batmanatucsd/uMouse/3D Design/MotorMount.stl

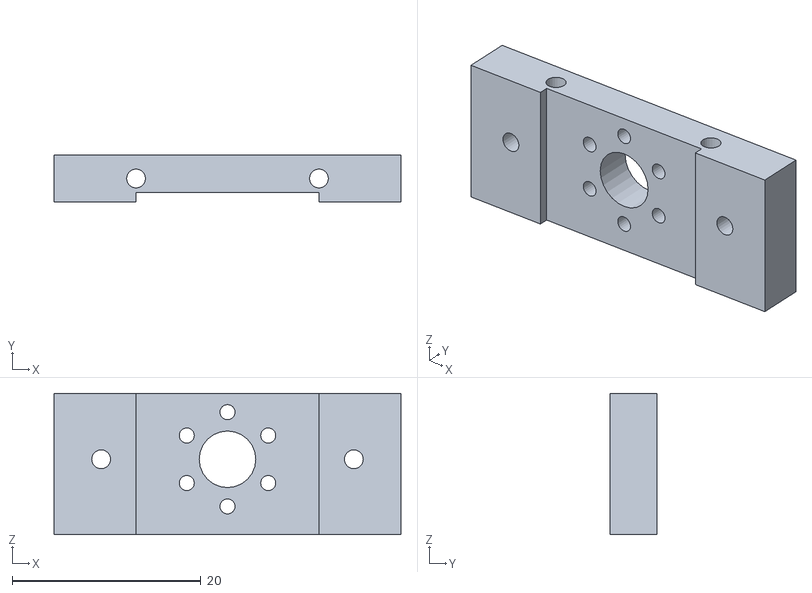
[picture p1: CAD file, 2015-02-12]
3D Design/MotorMount.stl
36.8 x 5.00 x 15.0
