batmanatucsd/uMouse/3D Design/Wheel.stl

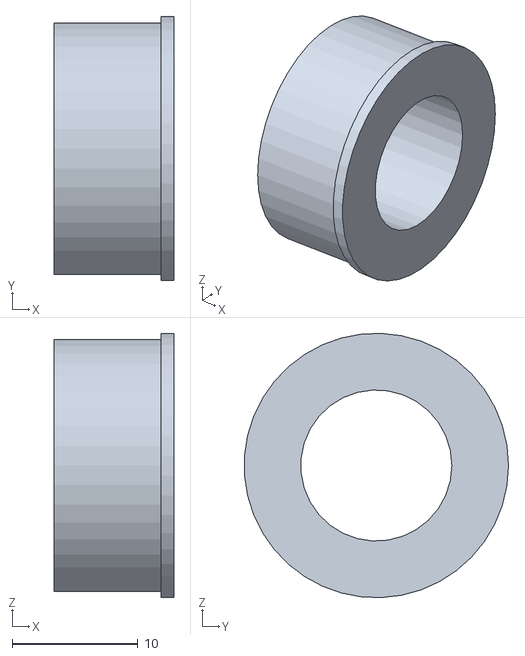
[picture p2: CAD file, 2015-02-12]
3D Design/Wheel.stl
9.50 x 21.0 x 21.0
