batmanatucsd/uMouse/(list of files, cad)

Other CAD files:
3D Design/MotorMount.dwg
3D Design/Wheel.dwg
