batmanatucsd/uMouse/Code/Algm/testmaze1.gif

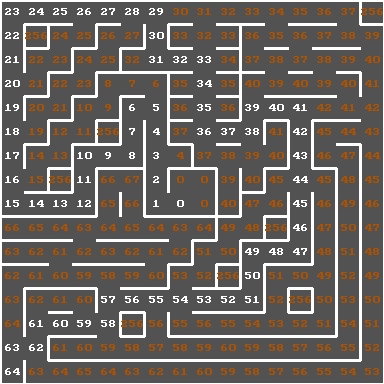
Code/Algm/testmaze1.gif
