batmanatucsd/uMouse/PCB Design/mouse_design/mouse_design.brd

## EAGLE design PCB Design/mouse_design/mouse_design.brd (2015-03-25)

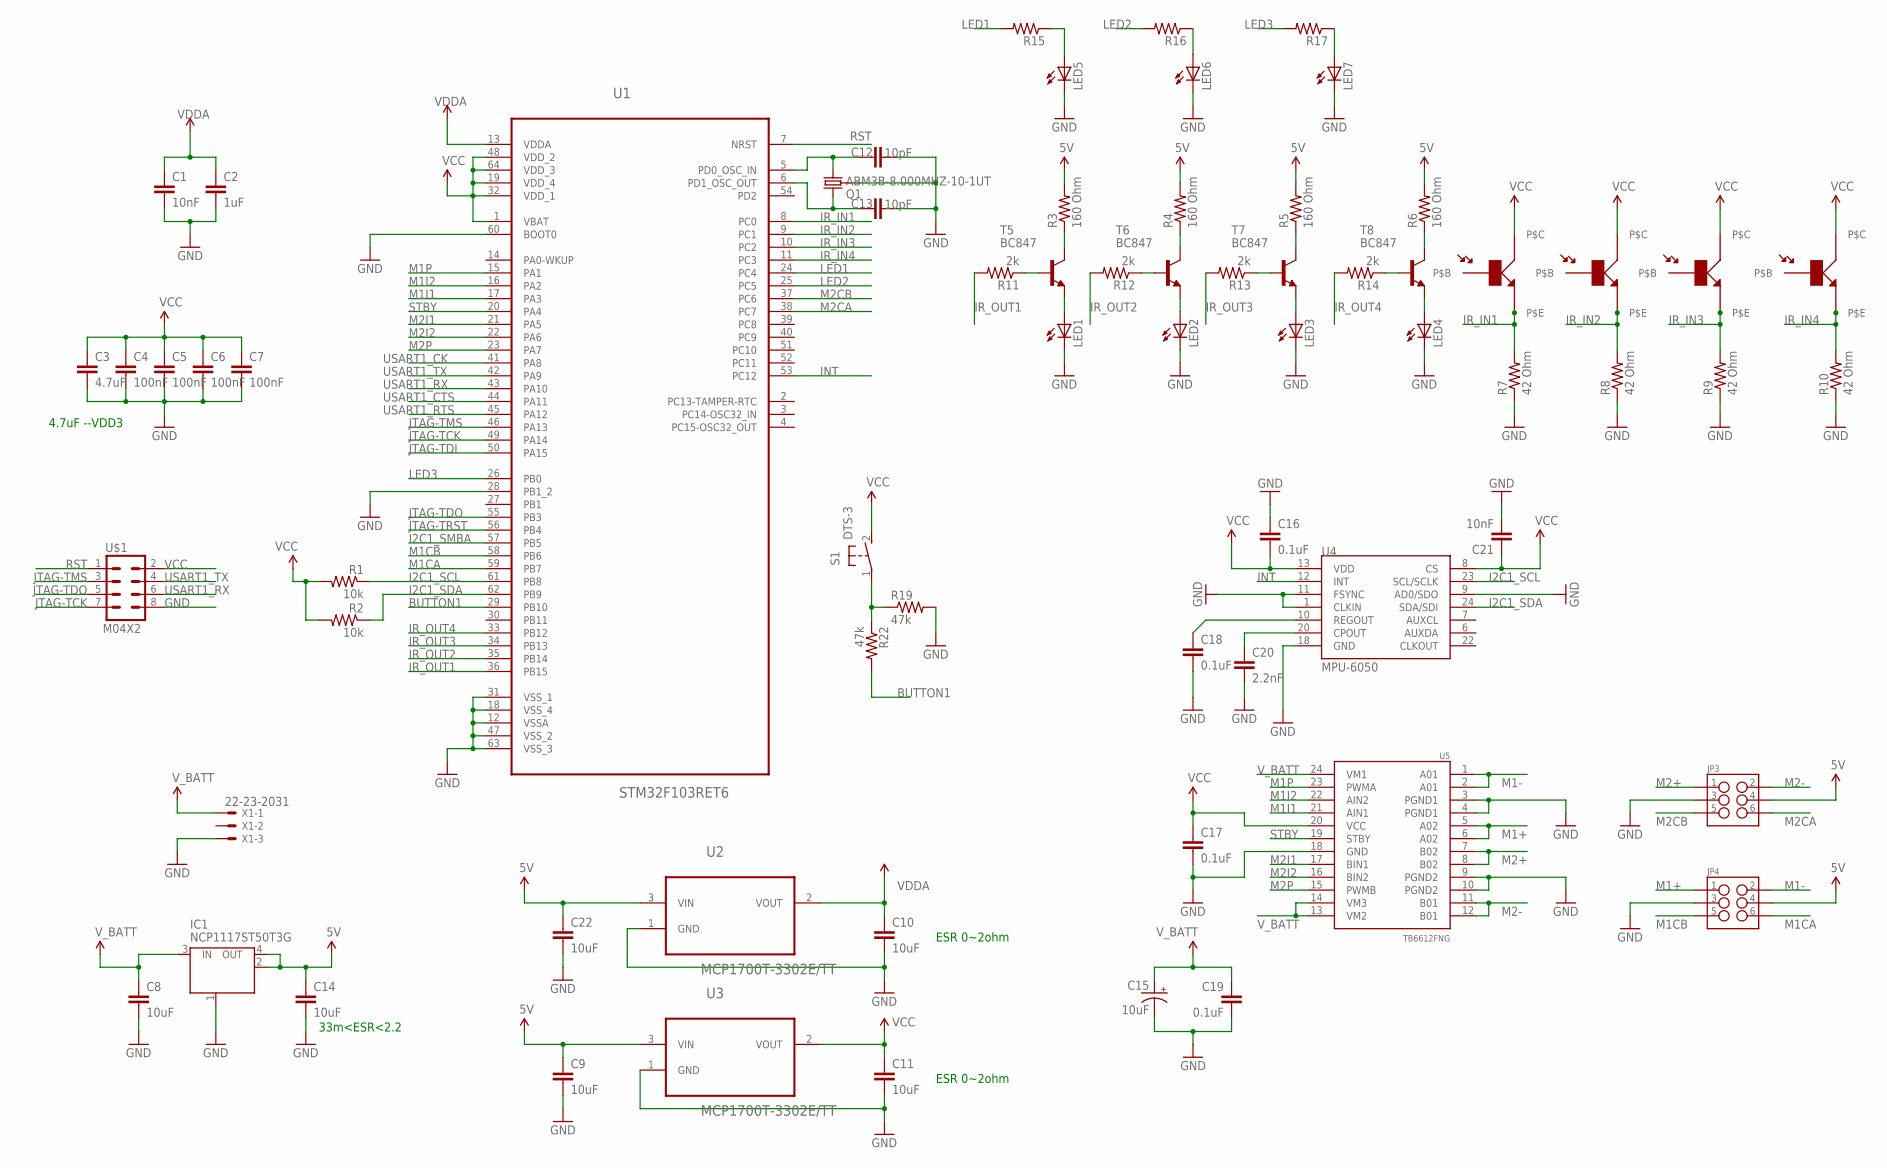
[picture p4: schematic mouse_design.sch]

Parts:
C1, C21: 10nF; 0805
C2: 1uF; 0805
C3: 4.7uF; 0805
C4, C5, C6, C7: 100nF; 0805
C8, C9, C10, C11, C14, C22: 10uF; 0805
C12, C13: 10pF; 0805
C15: 10uF; EIA3216-KIT
C16, C17, C18, C19: 0.1uF; 0805
C20: 2.2nF; 0805
IC1: NCP1117ST50T3G; SOT223
JP3, JP4: M03X2NO_SILK; 2X3-NS
LED1, LED2, LED3, LED4: LED5MM
LED5, LED6, LED7: LEDSML0805; SML0805
Q1: ABM3B-8.000MHZ-10-1UT; CRYSTAL-SMD-5X3
R1, R2: 10k; 0805
R3, R4, R5, R6: 160 Ohm; 0805
R7, R8, R9, R10: 42 Ohm; 0805
R11, R12, R13, R14: 2k; 0805
R15, R16, R17: RESISTOR0805-RES; 0805
R19, R22: 47k; 0805
S1: DTS-3
T5, T6, T7, T8: BC847; SOT23
U1: STM32F103RET6; QFP50P1200X1200X160-64N
U2, U3: MCP1700T-3302E/TT; SOT95P237X112-3N
U4: MPU-6050; QFN-24-TESTING
U5: TB6612FNG; SSOP24
U$1: M04X2; 2X4
U$2, U$3, U$4, U$5: PHTRST
X1: 22-23-2031

Connections:
5V: C9.1, C14.1, C22.1, IC1.2 (OUT), IC1.4 (OUT), JP3.4, JP4.4, R3.2, R4.2, R5.2, R6.2, U2.3 (VIN), U3.3 (VIN)
BUTTON1: R22.2, U1.29 (PB10)
GND: C1.2, C2.2, C3.2, C4.2, C5.2, C6.2, C7.2, C8.2, C9.2, C10.2, C11.2, C12.1, C13.1, C14.2, C15.C (-), C16.1, C17.2, C18.2, C19.2, C20.2, C21.2, C22.2, IC1.1 (GND/ADJ), JP3.3, JP4.3, LED1.K (C), LED2.K (C), LED3.K (C), LED4.K (C), LED5.C, LED6.C, LED7.C, Q1.2 (3), Q1.4 (3), R7.1, R8.1, R9.1, R10.1, R19.2, U1.12 (VSSA), U1.18 (VSS_4), U1.28 (PB1_2), U1.31 (VSS_1), U1.47 (VSS_2), U1.60 (BOOT0), U1.63 (VSS_3), U2.1 (GND), U3.1 (GND), U4.1 (CLKIN), U4.9 (AD0/SDO), U4.11 (FSYNC), U4.18 (GND), U5.3 (PGND1), U5.4 (PGND1), U5.9 (PGND2), U5.10 (PGND2), U5.18 (GND), U$1.8, X1.3
I2C1_SCL: R1.1, U1.61 (PB8), U4.23 (SCL/SCLK)
I2C1_SDA: R2.1, U1.62 (PB9), U4.24 (SDA/SDI)
I2C1_SMBA: U1.57 (PB5)
INT: U1.53 (PC12), U4.12 (INT)
IR_IN1: R7.2, U1.8 (PC0), U$2.P$E
IR_IN2: R8.2, U1.9 (PC1), U$3.P$E
IR_IN3: R9.2, U1.10 (PC2), U$4.P$E
IR_IN4: R10.2, U1.11 (PC3), U$5.P$E
IR_OUT1: R11.2, U1.36 (PB15)
IR_OUT2: R12.2, U1.35 (PB14)
IR_OUT3: R13.2, U1.34 (PB13)
IR_OUT4: R14.2, U1.33 (PB12)
JTAG-TCK: U1.49 (PA14), U$1.7
JTAG-TDI: U1.50 (PA15)
JTAG-TDO: U1.55 (PB3), U$1.5
JTAG-TMS: U1.46 (PA13), U$1.3
JTAG-TRST: U1.56 (PB4)
LED1: R15.2, U1.24 (PC4)
LED2: R16.2, U1.25 (PC5)
LED3: R17.2, U1.26 (PB0)
M1+: JP4.1, U5.5 (A02), U5.6 (A02)
M1-: JP4.2, U5.1 (A01), U5.2 (A01)
M1CA: JP4.6, U1.59 (PB7)
M1CB: JP4.5, U1.58 (PB6)
M1I1: U1.17 (PA3), U5.21 (AIN1)
M1I2: U1.16 (PA2), U5.22 (AIN2)
M1P: U1.15 (PA1), U5.23 (PWMA)
M2+: JP3.1, U5.7 (B02), U5.8 (B02)
M2-: JP3.2, U5.11 (B01), U5.12 (B01)
M2CA: JP3.6, U1.38 (PC7)
M2CB: JP3.5, U1.37 (PC6)
M2I1: U1.21 (PA5), U5.17 (BIN1)
M2I2: U1.22 (PA6), U5.16 (BIN2)
M2P: U1.23 (PA7), U5.15 (PWMB)
unnamed: C12.2, Q1.3 (1), U1.5 (PD0_OSC_IN)
unnamed: R4.1, T6.3 (C)
unnamed: LED1.A, T5.2 (E)
unnamed: LED2.A, T6.2 (E)
unnamed: C13.2, Q1.1 (2), U1.6 (PD1_OSC_OUT)
unnamed: LED3.A, T7.2 (E)
unnamed: C20.1, U4.20 (CPOUT)
unnamed: C18.1, U4.10 (REGOUT)
unnamed: LED4.A, T8.2 (E)
unnamed: R3.1, T5.3 (C)
unnamed: R5.1, T7.3 (C)
unnamed: R6.1, T8.3 (C)
unnamed: R14.1, T8.1 (B)
unnamed: R13.1, T7.1 (B)
unnamed: R12.1, T6.1 (B)
unnamed: R11.1, T5.1 (B)
unnamed: LED5.A, R15.1
unnamed: LED6.A, R16.1
unnamed: LED7.A, R17.1
unnamed: R19.1, R22.1, S1.1
RST: U1.7 (NRST), U$1.1
STBY: U1.20 (PA4), U5.19 (STBY)
USART1_CK: U1.41 (PA8)
USART1_CTS: U1.44 (PA11)
USART1_RTS: U1.45 (PA12)
USART1_RX: U1.43 (PA10), U$1.6
USART1_TX: U1.42 (PA9), U$1.4
VCC: C3.1, C4.1, C5.1, C6.1, C7.1, C11.1, C16.2, C17.1, C21.1, R1.2, R2.2, S1.2, U1.1 (VBAT), U1.19 (VDD_4), U1.32 (VDD_1), U1.48 (VDD_2), U1.64 (VDD_3), U3.2 (VOUT), U4.8 (CS), U4.13 (VDD), U5.20 (VCC), U$1.2, U$2.P$C, U$3.P$C, U$4.P$C, U$5.P$C
VDD: C1.1, C2.1, C10.1, U1.13 (VDDA), U2.2 (VOUT)
V_BATT: C8.1, C15.A (+), C19.1, IC1.3 (IN), U5.13 (VM2), U5.14 (VM3), U5.24 (VM1), X1.1

Notes on the sheet:
ESR 0~2ohm
4.7uF --VDD3
33m<ESR<2.2

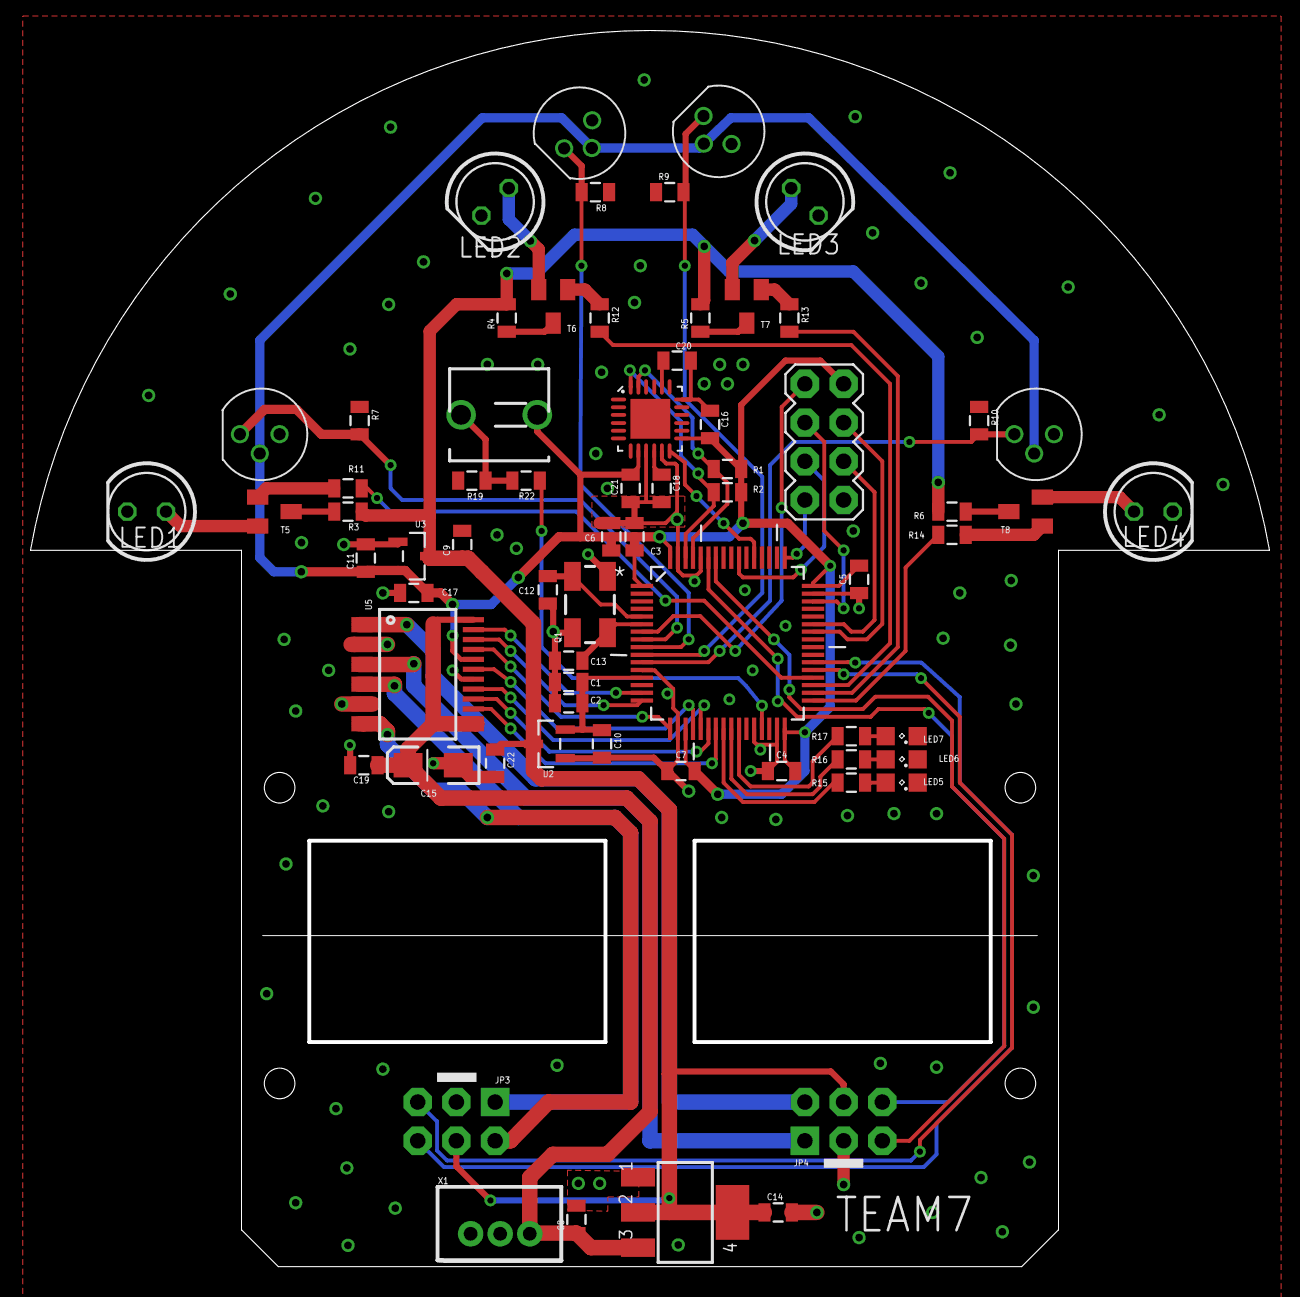
[picture p5: board mouse_design.brd from above]

Board: 2 copper layers, 81.3 x 81.1 mm, 68 parts (0 on the bottom side), 61 nets.
