batmanatucsd/uMouse/Code/src/uMouse.c

#include "mouse.h"
#include "anbt_dmp_driver.h"
#include "anbt_dmp_fun.h"
#include "anbt_dmp_mpu6050.h"

/*****************************************************************************/
// Global Variables
/*****************************************************************************/
__IO uint16_t sensor_buffers[4];
__IO uint16_t sensor_readings[4];
extern float angle[3];
extern int16_t raw_data[6];
extern int16_t offset[6];

/*****************************************************************************/
// Main Function
/*****************************************************************************/
int main(void)
{
  // MCU Configurations
  RCC_Configuration();
  GPIO_Configuration();
  DMA_Configuration();
  NVIC_Configuration();

  ADC_Configuration();
  PWM_Configuration();
  ENCODER_Configuration();



  // Only for debug
  USART_Configuration();
  ANBT_I2C_Configuration();
  AnBT_DMP_MPU6050_Init();

  mouse_state = STOP;
  mouse_status = FORWARD;

  while(1)
  {
	  listen_for_button();

	  printf("test");

	  // Listen to button push
	  listen_for_button();

	  switch(mouse_state){
		  case GO:
			  /*****************************************CELL BY CELL MOVEMENT****************************/


			     ADC_Read(1,0,0,1);

			     if(sensor_buffers[L_IR] > 120 && sensor_buffers[R_IR] > 120){
			     stopFrontWall();

			     if(sensor_buffers[L_IR]>400){

			     change_LeftMotorSpeed(0);
			     change_RightMotorSpeed(0);

			     Delay_us(1000);
			     rightTurn();
			     Delay_us(10000);

			     }
			     }
			     else{
				  L_ENC->CNT=0;
				  R_ENC->CNT=0;

				  while(L_ENC->CNT < 6005 && R_ENC->CNT < 6005){
					  change_LeftMotorSpeed(80);
					  change_RightMotorSpeed(80);
					  pid();

					  if(L_ENC->CNT >3000 && L_ENC->CNT<4000){
						  change_LeftMotorSpeed(60);
						  change_RightMotorSpeed(60);
						  pid();
					  }

					  if(L_ENC->CNT>=4000 && L_ENC->CNT<5000){
						  change_LeftMotorSpeed(40);
						  change_RightMotorSpeed(40);
						  pid();
					  }

				  }
				  change_LeftMotorSpeed(0);
				  change_RightMotorSpeed(0);


				  Delay_us(1000000);
				  L_ENC->CNT=0;
				  R_ENC->CNT=0;

			}










			  /******************************LEFT 90 TURN******************************************/
			  /*	ADC_Read(1,0,0,1);

				if(sensor_buffers[L_IR] > 120 && sensor_buffers[R_IR] > 120){
				stopFrontWall();

				if(sensor_buffers[L_IR]>400){

				change_LeftMotorSpeed(0);
				change_RightMotorSpeed(0);

				Delay_us(1000);
				leftTurn();
				Delay_us(10000);

				}
				}
				else{
				change_LeftMotorSpeed(150);
				change_RightMotorSpeed(150);
				pid();

				}
			   */


			  /*******************************TEST SMOOTH RIGHT***********************************/
			  /*	ADC_Read(1,1,1,1);

				change_LeftMotorSpeed(150);
				change_RightMotorSpeed(150);
				pid();
				rightTurn();
			   */

			  break;


		  case TEST:


			  /******************************straight, stop, right, etc *****************/
/*
			     ADC_Read(1,0,0,1);

			     if(sensor_buffers[L_IR] > 120 && sensor_buffers[R_IR] > 120){
			     stopFrontWall();

			     if(sensor_buffers[L_IR]>400){

			     change_LeftMotorSpeed(0);
			     change_RightMotorSpeed(0);

			     Delay_us(1000);
			     rightTurn();
			     Delay_us(10000);

			     }
			     }
			     else{
			     change_LeftMotorSpeed(150);
			     change_RightMotorSpeed(150);
			     pid();
			     }

*/
			  /*******************************straight, stop, 180, go ********************/

			     ADC_Read(1,0,0,1);
			     if(sensor_buffers[L_IR] > 120 && sensor_buffers[R_IR] > 120){
			     stopFrontWall();

			     if(sensor_buffers[L_IR]>490){

			     Delay_us(1000);
			     rightTurn();
			     Delay_us(10000);
			     }
			     }
			     else{
			     change_LeftMotorSpeed(150);
			     change_RightMotorSpeed(150);
			     pid();
			     }




			  GPIO_SetBits(GPIOC, GREEN);
			  GPIO_ResetBits(GPIOB, RED);
			  GPIO_ResetBits(GPIOC, YELLOW);
			  break;

		  case STOP:

			  //ADC_Read(1, 1, 1, 1);
			  turnMotorOff();
			  GPIO_SetBits(GPIOB, RED);
			  GPIO_ResetBits(GPIOC, GREEN);
			  GPIO_SetBits(GPIOC, YELLOW);

			  /*printf("  sensor reading: %u         %u        %u        %u\r\n",*/
			  /*sensor_buffers[3], sensor_buffers[2], sensor_buffers[1], sensor_buffers[0]);*/

			  /*Free our mouse*/
			  if(sensor_buffers[R_IR] >= 450) {
				  Delay_us(10000);
				  mouse_state = GO;
			  }
			  /*if(sensor_buffers[L_IR] >= 450) {*/
			  /*Delay_us(10000);*/
			  /*calibrate();*/
			  /*GPIO_SetBits(GPIOC, GREEN);*/
			  /*Delay_us(10000);*/
			  /*}*/

			  break;

	  /*printf("%u            %u\r\n", TIM3->CCR3, TIM4->CCR4);*/
	  /*printf("                                                  %u              %u\r\n", L_ENC->CNT, R_ENC->CNT);*/
	  /*    ADC_Read(1,1,1,1);
		printf("                                                    %u      %u      %u\r\n"
		sensor_readings[0], sensor_readings[1], sensor_readings[2], sensor_readings[3]);*/
	  /*ADC1->JDR1, ADC1->JDR2, ADC1->JDR3, ADC1->JDR4);*/
	  /*ADC1->JOFR1, ADC1->JOFR2, ADC1->JOFR3, ADC1->JOFR4);*/
	  /*printf("%u            %u\r\n", TIM8->CNT, TIM4->CNT);*/
	  /*if(TIM8->CNT > 7000)*/
	  /*turnMotorOff();*/

  }
}
}
