batmanatucsd/uMouse/Code/src/pid.h

#ifndef PID_H
#define PID_H

// Constants
// IR_OUT:
// 1 - left
// 2 - front left
// 3 - front right
// 4 - right

#include "mouse.h"
#define RIGHT_THRESHOLD 200
#define LEFT_THRESHOLD 130


#define KP 0.01000
#define KD 0.2
#define KI 0
#define ADJUST 600

#ifndef HIGH
#define HIGH 1
#endif

#ifndef LOW
#define LOW 0
#endif

typedef enum {
  BOTH, RIGHT, LEFT, NOWALLS
} PID_CASE;

/*****************************************************************************/
// Calibrated values
/*****************************************************************************/
static uint16_t RIGHTWALL_TARGET = 300;
static uint16_t LEFTWALL_TARGET = 300;
static uint16_t OFFSET = 0; 

/*****************************************************************************/
// Functions
/*****************************************************************************/
void pid(void);
void calibrate(void);

#endif // PID_H
