batmanatucsd/uMouse/Code/src/mcu_lib.c

#include "mcu_lib.h"

/*****************************************************************************/
// Global Variables
/*****************************************************************************/
__IO uint16_t readADC_status = 0;
static __IO int16_t wait_time = 0;
__IO uint16_t waiting = 0;
__IO uint16_t sensor_buffers[4];
__IO uint16_t sensor_readings[4];

/*****************************************************************************/
// RCC_Configuration
//
// @brief: Configure clocks for the peripherals
/*****************************************************************************/
void RCC_Configuration(void) /*{{{*/
{
	/* PCLK2 is the APB2 clock */
  /* ADCCLK = PCLK2/6 = 72/6 = 12MHz*/
  // RCC_ADCCLKConfig(RCC_PCLK2_Div6);

  //enable DMA1 clock
  RCC_AHBPeriphClockCmd(RCC_AHBPeriph_DMA1 | RCC_AHBPeriph_DMA2, ENABLE);

  /* ADCCLK = PCLK2/4 for ADC */
  RCC_ADCCLKConfig(RCC_PCLK2_Div4);

   /* TIM clock enable for PWM */
  RCC_APB1PeriphClockCmd(RCC_APB1Periph_TIM3 | RCC_APB1Periph_TIM5, ENABLE);

  /* TIM clock enable for Encoder */
  RCC_APB1PeriphClockCmd(RCC_APB1Periph_TIM4, ENABLE);
  RCC_APB2PeriphClockCmd(RCC_APB2Periph_TIM8, ENABLE);

  // TODO: TIM clock enable for encoder counts

  /* GPIO, ADC clock enable */
  RCC_APB2PeriphClockCmd(RCC_APB2Periph_GPIOA | RCC_APB2Periph_GPIOB |
                         RCC_APB2Periph_GPIOC | RCC_APB2Periph_AFIO |
                         RCC_APB2Periph_ADC3 | RCC_APB2Periph_ADC3, ENABLE);

}/*}}}*/

/*****************************************************************************/
// GPIO_Configuration
//
// @brief: Set general purpose input & output pin configurations
/*****************************************************************************/
void GPIO_Configuration(void) /*{{{*/
{
	GPIO_InitTypeDef GPIO_InitStructure;

	// ***** For LED's ***** //
  GPIO_InitStructure.GPIO_Pin = GPIO_Pin_5 | GPIO_Pin_4;
  GPIO_InitStructure.GPIO_Speed = GPIO_Speed_50MHz;
  GPIO_InitStructure.GPIO_Mode = GPIO_Mode_Out_PP;
  GPIO_Init(GPIOC, &GPIO_InitStructure);

  GPIO_InitStructure.GPIO_Pin = GPIO_Pin_0;
  GPIO_InitStructure.GPIO_Speed = GPIO_Speed_50MHz;
  GPIO_InitStructure.GPIO_Mode = GPIO_Mode_Out_PP;
  GPIO_Init(GPIOB, &GPIO_InitStructure);

	// ***** For Push Button ***** //
  GPIO_InitStructure.GPIO_Pin = GPIO_Pin_10;
  GPIO_InitStructure.GPIO_Speed = GPIO_Speed_50MHz;
  GPIO_InitStructure.GPIO_Mode = GPIO_Mode_IN_FLOATING;
  GPIO_Init(GPIOB, &GPIO_InitStructure);

	// ***** For IR Sensors ***** //
  GPIO_InitStructure.GPIO_Pin = GPIO_Pin_0 | GPIO_Pin_1 |
                                GPIO_Pin_2 | GPIO_Pin_3;
  GPIO_InitStructure.GPIO_Mode = GPIO_Mode_AIN;
  GPIO_Init(GPIOC, &GPIO_InitStructure);

  GPIO_InitStructure.GPIO_Pin = GPIO_Pin_12 | GPIO_Pin_13 |
                                GPIO_Pin_14 | GPIO_Pin_15;
  GPIO_InitStructure.GPIO_Speed = GPIO_Speed_50MHz;
  GPIO_InitStructure.GPIO_Mode = GPIO_Mode_Out_PP;
  GPIO_Init(GPIOB, &GPIO_InitStructure);

	// ***** For Motor Controls ***** //
  GPIO_InitStructure.GPIO_Pin = GPIO_Pin_4 | GPIO_Pin_2 | GPIO_Pin_3 |
                                GPIO_Pin_5 | GPIO_Pin_6;
  GPIO_InitStructure.GPIO_Speed = GPIO_Speed_50MHz;
  GPIO_InitStructure.GPIO_Mode = GPIO_Mode_Out_PP;
  GPIO_Init(GPIOA, &GPIO_InitStructure);

	// ***** For PWM output ***** //
  GPIO_InitStructure.GPIO_Pin = GPIO_Pin_1 | GPIO_Pin_7;
  GPIO_InitStructure.GPIO_Mode = GPIO_Mode_AF_PP;
  GPIO_InitStructure.GPIO_Speed = GPIO_Speed_50MHz;
  GPIO_Init(GPIOA, &GPIO_InitStructure);

	// ***** For Encoder Inputs ***** //
  GPIO_InitStructure.GPIO_Pin = GPIO_Pin_6 | GPIO_Pin_7;
  GPIO_InitStructure.GPIO_Mode = GPIO_Mode_IPU;
  GPIO_InitStructure.GPIO_Speed = GPIO_Speed_50MHz;
  GPIO_Init(GPIOB, &GPIO_InitStructure);
  GPIO_Init(GPIOC, &GPIO_InitStructure);
}/*}}}*/

/*****************************************************************************
// DMA_Configuration
//
// @brief: Set configurations for DMA
/*****************************************************************************/
void DMA_Configuration(void) /*{{{*/
{
  //create DMA structure
  DMA_InitTypeDef  DMA_InitStructure;

  //reset DMA1 channe1 to default values;/*{{{*/
  DMA_DeInit(DMA2_Channel5);

  //channel will be used for memory to memory transfer
  DMA_InitStructure.DMA_M2M = DMA_M2M_Disable;
  //setting normal mode (non circular)
  DMA_InitStructure.DMA_Mode = DMA_Mode_Circular;
  //medium priority
  DMA_InitStructure.DMA_Priority = DMA_Priority_High;

  //chunk of data to be transfered
  DMA_InitStructure.DMA_BufferSize = 4; // use 4 when using 4 IR sensors
  //source and destination data size word=32bit
  DMA_InitStructure.DMA_PeripheralDataSize = DMA_PeripheralDataSize_HalfWord;
  DMA_InitStructure.DMA_MemoryDataSize = DMA_MemoryDataSize_HalfWord;

  //Location assigned to peripheral register will be source
  DMA_InitStructure.DMA_DIR = DMA_DIR_PeripheralSRC;

  //source and destination start addresses
  DMA_InitStructure.DMA_PeripheralBaseAddr = (uint32_t)&ADC3->DR;
  DMA_InitStructure.DMA_MemoryBaseAddr = (uint32_t)sensor_buffers;
  /*DMA_InitStructure.DMA_MemoryBaseAddr = (uint32_t)&ADC3->JOFR1;*/
  /*DMA_InitStructure.DMA_MemoryBaseAddr = (uint32_t)&ADC3->JOFR1;*/

  //source address increment disable
  DMA_InitStructure.DMA_PeripheralInc = DMA_PeripheralInc_Disable;
  //automatic memory destination increment enable.
  DMA_InitStructure.DMA_MemoryInc = DMA_MemoryInc_Enable;

  //send values to DMA registers
  DMA_Init(DMA2_Channel5, &DMA_InitStructure);
  /*Enable DMA1 Channel Transfer Complete interrupt*/
  DMA_ITConfig(DMA2_Channel5, DMA_IT_TC, ENABLE);
  DMA_Cmd(DMA2_Channel5, ENABLE); //Enable the DMA1 - Channel1/*}}}*/

  /*// DMA2 Channe5 Configuration;[>{{{<]*/
  /*DMA_DeInit(DMA2_Channel5);*/
  /*DMA_InitStructure.DMA_DIR = DMA_DIR_PeripheralSRC;*/
  /*[>DMA_InitStructure.DMA_PeripheralBaseAddr = (uint32_t)&ADC3->DR;<]*/
  /*DMA_InitStructure.DMA_PeripheralBaseAddr = (uint32_t)&ADC3->DR;*/
  /*DMA_InitStructure.DMA_MemoryBaseAddr = (uint32_t)sensor_readings;*/
  /*DMA_InitStructure.DMA_PeripheralInc = DMA_PeripheralInc_Disable;*/
  /*DMA_InitStructure.DMA_MemoryInc = DMA_MemoryInc_Enable;*/
  /*DMA_InitStructure.DMA_BufferSize = 4; // use 4 when using 4 IR sensors*/
  /*DMA_InitStructure.DMA_PeripheralDataSize = DMA_PeripheralDataSize_HalfWord;*/
  /*DMA_InitStructure.DMA_MemoryDataSize = DMA_MemoryDataSize_HalfWord;*/
  /*DMA_InitStructure.DMA_Priority = DMA_Priority_High;*/
  /*DMA_InitStructure.DMA_Mode = DMA_Mode_Circular;*/
  /*DMA_InitStructure.DMA_M2M = DMA_M2M_Disable;*/
  /*DMA_Init(DMA2_Channel5, &DMA_InitStructure);*/
  /*DMA_Cmd(DMA2_Channel5, ENABLE); //Enable the DMA1 - Channel1[>}}}<]*/
}/*}}}*/

/*****************************************************************************/
// ADC_Configuration
//
// @brief: Set configurations for analog input
/*****************************************************************************/
void ADC_Configuration(void) /*{{{*/
{
  ADC_InitTypeDef ADC_InitStructure;

  /* Put everything back to power-on defaults */
  ADC_DeInit(ADC3);
  /*ADC_DeInit(ADC3);*/

  /* ADC3 Configuration ------------------------------------------------------*/
  /* ADC3 and ADC3 operate independently */
  ADC_InitStructure.ADC_Mode = ADC_Mode_Independent;
  /* Disable the scan conversion so we do one at a time */
  ADC_InitStructure.ADC_ScanConvMode = ENABLE;
  /* Don't do contimuous conversions - do them on demand */
  ADC_InitStructure.ADC_ContinuousConvMode = ENABLE;

  // Start conversin by software, not an external trigger
  ADC_InitStructure.ADC_ExternalTrigConv = ADC_ExternalTrigConv_None;
  /* Conversions are 12 bit - put them in the lower 12 bits of the result */
  ADC_InitStructure.ADC_DataAlign = ADC_DataAlign_Right;
  /* Say how many channels would be used by the sequencer */
  ADC_InitStructure.ADC_NbrOfChannel = 4;
  /* Now do the setup */
  ADC_Init(ADC3, &ADC_InitStructure);

  ADC_RegularChannelConfig(ADC3, R_RECEIVER, 1, ADC_SampleTime_71Cycles5);
  ADC_RegularChannelConfig(ADC3, RF_RECEIVER, 2, ADC_SampleTime_71Cycles5);
  ADC_RegularChannelConfig(ADC3, LF_RECEIVER, 3, ADC_SampleTime_71Cycles5);
  ADC_RegularChannelConfig(ADC3, L_RECEIVER, 4, ADC_SampleTime_71Cycles5);

  /*[> Set injected sequencer length <]*/
  /*ADC_InjectedSequencerLengthConfig(ADC3, 4);*/
  /*[> ADC3 injected channel Configuration <]*/
  /*ADC_InjectedChannelConfig(ADC3, R_RECEIVER, 1, ADC_SampleTime_41Cycles5);*/
  /*ADC_InjectedChannelConfig(ADC3, RF_RECEIVER, 2, ADC_SampleTime_41Cycles5);*/
  /*ADC_InjectedChannelConfig(ADC3, LF_RECEIVER, 3, ADC_SampleTime_41Cycles5);*/
  /*ADC_InjectedChannelConfig(ADC3, L_RECEIVER, 4, ADC_SampleTime_41Cycles5);*/
  /*[> ADC3 injected external trigger configuration <]*/
  /*ADC_ExternalTrigInjectedConvConfig(ADC3, ADC_ExternalTrigInjecConv_None);*/

  /*[> Enable ADC3 Injected Channels in discontinous mode <]*/
  /*ADC_InjectedDiscModeCmd(ADC3, ENABLE);*/

  /*[> Enable ADC3 EOC interrupt <]*/
  /*ADC_ITConfig(ADC3, ADC_IT_JEOC, ENABLE);*/

  /*// ADC3 Configuration*/
  /*ADC_InitStructure.ADC_Mode = ADC_Mode_Independent;*/
  /*[> Disable the scan conversion so we do one at a time <]*/
  /*ADC_InitStructure.ADC_ScanConvMode = ENABLE;*/
  /*[> Don't do contimuous conversions - do them on demand <]*/
  /*ADC_InitStructure.ADC_ContinuousConvMode = ENABLE;*/

  /*// Start conversin by software, not an external trigger*/
  /*ADC_InitStructure.ADC_ExternalTrigConv = ADC_ExternalTrigConv_None;*/
  /*[> Conversions are 12 bit - put them in the lower 12 bits of the result <]*/
  /*ADC_InitStructure.ADC_DataAlign = ADC_DataAlign_Right;*/
  /*[> Say how many channels would be used by the sequencer <]*/
  /*ADC_InitStructure.ADC_NbrOfChannel = 4;*/
  /*[> Now do the setup <]*/
  /*ADC_Init(ADC3, &ADC_InitStructure);*/

  /*ADC_RegularChannelConfig(ADC3, R_RECEIVER, 1, ADC_SampleTime_41Cycles5);*/
  /*ADC_RegularChannelConfig(ADC3, RF_RECEIVER, 2, ADC_SampleTime_41Cycles5);*/
  /*ADC_RegularChannelConfig(ADC3, LF_RECEIVER, 3, ADC_SampleTime_41Cycles5);*/
  /*ADC_RegularChannelConfig(ADC3, L_RECEIVER, 4, ADC_SampleTime_41Cycles5);*/

  /*[> Enable ADC3 <]*/
  /*ADC_Cmd(ADC3, ENABLE);*/
  /*[>Enable DMA for ADC<]*/
  /*ADC_DMACmd(ADC3, ENABLE);*/

  /*[> Enable ADC3 EOC interrupt <]*/
  ADC_ITConfig(ADC3, ADC_IT_EOC, ENABLE);

  /* Enable ADC3 */
  ADC_Cmd(ADC3, ENABLE);
  /*Enable DMA for ADC*/
  ADC_DMACmd(ADC3, ENABLE);

  /* Enable ADC3 reset calibaration register */
  ADC_ResetCalibration(ADC3);
  /* Check the end of ADC3 reset calibration register */
  while(ADC_GetResetCalibrationStatus(ADC3));
  /* Start ADC3 calibaration */
  ADC_StartCalibration(ADC3);
  /* Check the end of ADC3 calibration */
  while(ADC_GetCalibrationStatus(ADC3));

  /*[> Enable ADC3 reset calibaration register <]*/
  /*ADC_ResetCalibration(ADC3);*/
  /*[> Check the end of ADC3 reset calibration register <]*/
  /*while(ADC_GetResetCalibrationStatus(ADC3));*/
  /*[> Start ADC3 calibaration <]*/
  /*ADC_StartCalibration(ADC3);*/
  /*[> Check the end of ADC3 calibration <]*/
  /*while(ADC_GetCalibrationStatus(ADC3));*/

  /*ADC_SoftwareStartInjectedConvCmd(ADC3, ENABLE);*/
}/*}}}*/

/*****************************************************************************/
// ADC_Read
//
// @brief: Gets analog input
// @param: channel : adc_channel to get the result from
/*****************************************************************************/
void ADC_Read(uint16_t l, uint16_t lf, uint16_t rf, uint16_t r) /*{{{*/
{
  /*ADC_RegularChannelConfig(ADC3, channel, rank, ADC_SampleTime_7Cycles5);*/
  // Start the conversion
  /*ADC_SoftwareStartConvCmd(ADC3, ENABLE);*/
  /*Wait until conversion completion*/
  /*while(ADC_GetFlagStatus(ADC3, ADC_FLAG_EOC) == RESET);*/
  /*Get the conversion value*/
  /*return ADC_GetConversionValue(ADC3);*/
  /*ADC_SoftwareStartConvCmd(ADC3, DISABLE);*/
  /*ADC_SoftwareStartInjectedConvCmd(ADC3, DISABLE);*/

  readADC_status = 1;

  GPIO_SetBits(EMITTER, R_EMITTER);
  GPIO_SetBits(EMITTER, RF_EMITTER);
  GPIO_SetBits(EMITTER, LF_EMITTER);
  GPIO_SetBits(EMITTER, L_EMITTER);

  /*GPIO_WriteBit(EMITTER, R_EMITTER, r);*/
  /*GPIO_WriteBit(EMITTER, RF_EMITTER, rf);*/
  /*GPIO_WriteBit(EMITTER, LF_EMITTER, lf);*/
  /*GPIO_WriteBit(EMITTER, L_EMITTER, l);*/

  Delay_us(80);
  ADC_SoftwareStartConvCmd(ADC3, ENABLE);
  /* Start the conversion */
  /*ADC_SoftwareStartConvCmd(ADC3, ENABLE);*/
  /*ADC_SoftwareStartInjectedConvCmd(ADC3, ENABLE);*/
  while(readADC_status);
  /*while(ADC_GetFlagStatus(ADC3, ADC_FLAG_JEOC) == RESET);*/

  /*printf("ADC3 reading: %u         %u        %u        %u\r\n",*/
        /*sensor_buffers[0], sensor_buffers[1], sensor_buffers[2], sensor_buffers[3]);*/
  /*ADC_SoftwareStartConvCmd(ADC3, DISABLE);*/
  GPIO_ResetBits(GPIOB, GPIO_Pin_12);
  GPIO_ResetBits(GPIOB, GPIO_Pin_13);
  GPIO_ResetBits(GPIOB, GPIO_Pin_14);
  GPIO_ResetBits(GPIOB, GPIO_Pin_15);
}/*}}}*/

/*****************************************************************************/
// PWM_Configuration
//
// @brief: Set configurations for PWM
/*****************************************************************************/
void PWM_Configuration(void) /*{{{*/
{
  TIM_TimeBaseInitTypeDef  TIM_TimeBaseStructure;
  TIM_OCInitTypeDef  TIM_OCInitStructure;

	// Compute the prescaler value
  uint16_t PrescalerValue = (uint16_t) (SystemCoreClock / 24000000) - 1;

  // Time base configuration
  TIM_TimeBaseStructure.TIM_Period = 1500;
  TIM_TimeBaseStructure.TIM_Prescaler = PrescalerValue;
  TIM_TimeBaseStructure.TIM_ClockDivision = 0;
  TIM_TimeBaseStructure.TIM_CounterMode = TIM_CounterMode_Up;

  TIM_TimeBaseInit(L_PWM, &TIM_TimeBaseStructure); // Initialize TIM3
  TIM_TimeBaseInit(R_PWM, &TIM_TimeBaseStructure); // Initialize TIM5

  // Channel Configuration
  // Mode: PWM1
  // Polarity: HIGH
  TIM_OCInitStructure.TIM_OCMode = TIM_OCMode_PWM1;
  TIM_OCInitStructure.TIM_OCPolarity = TIM_OCPolarity_High;

  // TIM 5 Channel2 for RIGHT Motor
  TIM_OCInitStructure.TIM_OutputState = TIM_OutputState_Enable;
  TIM_OCInitStructure.TIM_Pulse = 120;
  /*TIM_OCInitStructure.TIM_Pulse = 190;*/

  TIM_OC2Init(R_PWM, &TIM_OCInitStructure);
  TIM_OC2PreloadConfig(R_PWM, TIM_OCPreload_Enable);

  // TODO: might need to change the TIMer
  // TIM3 Channel2 for LEFT Motor
  TIM_OCInitStructure.TIM_OutputState = TIM_OutputState_Enable;
  TIM_OCInitStructure.TIM_Pulse = 115;
  /*TIM_OCInitStructure.TIM_Pulse = 190;*/

  TIM_OC2Init(L_PWM, &TIM_OCInitStructure);
  TIM_OC2PreloadConfig(L_PWM, TIM_OCPreload_Enable);

  TIM_ARRPreloadConfig(R_PWM, ENABLE);
  TIM_ARRPreloadConfig(L_PWM, ENABLE);

  // TIM3,5 enable counter
  TIM_Cmd(R_PWM, ENABLE);
  TIM_Cmd(L_PWM, ENABLE);
}/*}}}*/

/*****************************************************************************/
// ENCODER_Configuration
//
// @brief: Set configurations for Encoder readings
//         TIM4 is for RIGHT motor
//         TIM8 is for LEFT motor
/*****************************************************************************/
void ENCODER_Configuration(void) {/*{{{*/
  TIM_TimeBaseInitTypeDef  TIM_TimeBaseStructure;
  TIM_ICInitTypeDef  TIM_ICInitStructure;

  TIM_DeInit(L_ENC);
  TIM_DeInit(R_ENC);

  TIM_TimeBaseStructure.TIM_Prescaler = 0;  // No prescaling
  TIM_TimeBaseStructure.TIM_Period = 65535; // max resolution value
  TIM_TimeBaseStructure.TIM_ClockDivision = TIM_CKD_DIV1;
  TIM_TimeBaseStructure.TIM_CounterMode = TIM_CounterMode_Up;

  TIM_TimeBaseInit(L_ENC, &TIM_TimeBaseStructure);
  TIM_TimeBaseInit(R_ENC, &TIM_TimeBaseStructure);

  TIM_EncoderInterfaceConfig(L_ENC, TIM_EncoderMode_TI12,
                         TIM_ICPolarity_Falling, TIM_ICPolarity_Falling);
  TIM_ICStructInit(&TIM_ICInitStructure);
  TIM_ICInitStructure.TIM_ICFilter = 6;//ICx_FILTER;
  TIM_ICInit(L_ENC, &TIM_ICInitStructure);

  TIM_EncoderInterfaceConfig(R_ENC, TIM_EncoderMode_TI12,
                         TIM_ICPolarity_Rising, TIM_ICPolarity_Rising);
  TIM_ICStructInit(&TIM_ICInitStructure);
  TIM_ICInitStructure.TIM_ICFilter = 6;//ICx_FILTER;
  TIM_ICInit(R_ENC, &TIM_ICInitStructure);

  // Initial interuppt structures
  // //  NVIC_InitStructure.NVIC_IRQChannel = TIM3_UP_IRQChannel;
  // //  NVIC_InitStructure.NVIC_IRQChannelPreemptionPriority = 1;
  // //  NVIC_InitStructure.NVIC_IRQChannelSubPriority = 0;
  // //  NVIC_InitStructure.NVIC_IRQChannelCmd = ENABLE;
  // //  NVIC_Init(&NVIC_InitStructure);
  // //  NVIC_InitStructure.NVIC_IRQChannel = TIM3_IRQChannel;
  // //  NVIC_Init(&NVIC_InitStructure);
  // //
  // //  // Clear all pending interrupts
  // //  TIM_ClearFlag(ENCODER_TIM, TIM_FLAG_Update);
  // //  TIM_ITConfig(ENCODER_TIM, TIM_IT_Update, ENABLE);

  // reset encoder counts
  L_ENC->CNT = 50; // prevent counts to become negative when the moved backwards
  R_ENC->CNT = 50;
  TIM_Cmd(L_ENC, ENABLE);
  TIM_Cmd(R_ENC, ENABLE);
}/*}}}*/

/*****************************************************************************/
// NVIC_Configuration
//
// @brief: Set configurations for NVIC
/*****************************************************************************/
void NVIC_Configuration(void)/*{{{*/
{
  NVIC_InitTypeDef NVIC_InitStructure;

  /* Configure and enable ADC interrupt */
  /*NVIC_InitStructure.NVIC_IRQChannel = ADC3_IRQn;*/
  /*NVIC_InitStructure.NVIC_IRQChannelPreemptionPriority = 0;*/
  /*NVIC_InitStructure.NVIC_IRQChannelSubPriority = 0;*/
  /*NVIC_InitStructure.NVIC_IRQChannelCmd = ENABLE;*/
  /*NVIC_Init(&NVIC_InitStructure);*/

  /* Enable DMA1 channel IRQ Channel */
  NVIC_InitStructure.NVIC_IRQChannel = DMA2_Channel4_5_IRQn;
  NVIC_InitStructure.NVIC_IRQChannelPreemptionPriority = 0;
  NVIC_InitStructure.NVIC_IRQChannelSubPriority = 1;
  NVIC_InitStructure.NVIC_IRQChannelCmd = ENABLE;
  NVIC_Init(&NVIC_InitStructure);
}/*}}}*/

/*****************************************************************************/
// Delay_Init
//
// @brief: Set configurations for delay functions
// @param: SYSCLK : System Clock
/*****************************************************************************/
void Delay_Init() //SYSCLK1000000??72MHz?72  /*{{{*/
{
    SysTick->CTRL&=0xFFFFFFFB;
    /*FAC_US=SYSCLK/8;  */
    /*FAC_MS=(u16t)(FAC_US*1000);       */
}  /*}}}*/

/*****************************************************************************/
// Delay_us
//
// @brief: Delay for given amount of microseconds
// @param: nus : microseconds
/*****************************************************************************/
void Delay_us(uint32_t wait_for)  /*{{{*/
{

  /*Set up system clock*/
  if(SysTick_Config(SystemCoreClock / 100000)){
    while(1);
  }
  /*set systick interrupt priority*/
  /*NVIC_PriorityGroupConfig(NVIC_PriorityGroup_4);    //4 bits for preemp priority 0 bit for sub priority*/
  /*NVIC_SetPriority(SysTick_IRQn, 0);  //i want to make sure systick has highest priority amount all other interrupts))*/
  /*SysTick->LOAD  = ((SystemCoreClock/1000) & SysTick_LOAD_RELOAD_Msk) - 1; */
  wait_time = wait_for;
  waiting = 1;
  while(wait_time > 0);
  waiting = 0;
    /*uint32_t temp;  */
    /*SysTick->LOAD=nus*FAC_US; */
    /*SysTick->VAL=0x00;  */
    /*SysTick->CTRL=0x01;  */
    /*do  */
    /*{  */
        /*temp=SysTick->CTRL;  */
    /*}  */
    /*while(temp&0x01&&!(temp&0x10000));  */
    /*SysTick->CTRL=0x00;  */
    /*SysTick->VAL=0x00;     */
}  /*}}}*/


void Decrement_WaitTime(void) {
  --wait_time;
}

/*****************************************************************************/
// Delay_ms
//
// @brief: Delay for given amount of miliseconds
// @param: nms : milliseconds to delay
/*****************************************************************************/
void Delay_ms(uint16_t wait_for)  /*{{{*/
{
  SysTick->LOAD  = ((SystemCoreClock/1000) & SysTick_LOAD_RELOAD_Msk) - 1;
  wait_time = wait_for;
  waiting = 1;
  while(wait_time > 0);
  /*SysTick->CTRL = 0;*/
  waiting = 0;
    /*uint32_t temp;  */
    /*SysTick->LOAD=nus*FAC_US; */
    /*SysTick->VAL=0x00;  */
    /*SysTick->CTRL=0x01;  */
    /*do  */
    /*{  */
        /*temp=SysTick->CTRL;  */
    /*}  */
    /*while(temp&0x01&&!(temp&0x10000));  */
    /*SysTick->CTRL=0x00;  */
    /*SysTick->VAL=0x00;     */
}  /*}}}*/


/*****************************************************************************/
// REPEAT_Configuration
//
// @brief: Set configurations for repeat functions
//         TIM6 is used
/*****************************************************************************/
void REPEAT_Configuration(void)
{
  TIM_TimeBaseInitTypeDef  TIM_TimeBaseStructure;

  RCC_APB1PeriphClockCmd(RCC_APB1Periph_TIM6, ENABLE);

  RCC_APB1PeriphResetCmd(RCC_APB1Periph_TIM6, ENABLE);
  RCC_APB1PeriphResetCmd(RCC_APB1Periph_TIM6, DISABLE);

  TIM_TimeBaseStructure.TIM_Prescaler = 14400 -1;  //5kHz
  TIM_TimeBaseStructure.TIM_CounterMode = TIM_CounterMode_Up;
  TIM_TimeBaseStructure.TIM_Period = 0xFFFF;    //20ms
  TIM_TimeBaseStructure.TIM_ClockDivision = 0;
  TIM_TimeBaseStructure.TIM_RepetitionCounter = 0;

  TIM_TimeBaseInit(TIM6, &TIM_TimeBaseStructure);

  TIM_Cmd(TIM6, ENABLE);
}


//before calling the function remember to set last_count = TIM6 ->CNT
// void REPEAT_EXAMPLE()
// {
//   uint16_t current_count = TIM6 -> CNT;
//   uint16_t count_diff = current_count - last_count;
//
//   if(count_diff > time_diff)
//   {
//
//   }
//
//   last_count = current_count;
//   if (last_count > 0xBBBB)
//   {
//     TIM6 -> CNT = (TIM6 -> CNT) - last_count;
//     last_count = 0;
//   }
// }
