batmanatucsd/uMouse/Code/src/eMPL/mpu_basic.c

#include "mpu_basic.h"

#include "../mcu_delay.h"
#include "../mcu_soft_iic.h"

#include "inv_mpu.h"
#include "inv_mpu_dmp_motion_driver.h"

#include <math.h>

#define DEFAULT_MPU_HZ  (100)

#define q30 1073741824.0f
double q0, q1, q2, q3;
unsigned long sensor_timestamp;
short gyro_raw[3], accel_raw[3], sensors;
unsigned char more;
long quat[4];

static signed char gyro_orientation[9] = {-1, 0, 0,
                                           0,-1, 0,
                                           0, 0, 1};

/* These next two functions converts the orientation matrix (see
 * gyro_orientation) to a scalar representation for use by the DMP.
 * NOTE: These functions are borrowed from Invensense's MPL.
 */
static inline unsigned short inv_row_2_scale(const signed char *row)
{
    unsigned short b;

    if (row[0] > 0)
        b = 0;
    else if (row[0] < 0)
        b = 4;
    else if (row[1] > 0)
        b = 1;
    else if (row[1] < 0)
        b = 5;
    else if (row[2] > 0)
        b = 2;
    else if (row[2] < 0)
        b = 6;
    else
        b = 7;      // error
    return b;
}

static inline unsigned short inv_orientation_matrix_to_scalar(
    const signed char *mtx)
{
    unsigned short scalar;

    /*
        XYZ  010_001_000 Identity Matrix
        XZY  001_010_000
        YXZ  010_000_001
        YZX  000_010_001
        ZXY  001_000_010
        ZYX  000_001_010
    */
    scalar = inv_row_2_scale(mtx);
    scalar |= inv_row_2_scale(mtx + 3) << 3;
    scalar |= inv_row_2_scale(mtx + 6) << 6;

    return scalar;
}

int MPU_init(void)
{
    delay_init();
    I2C_init();

    mpu_init();

    /* Get/set hardware configuration. Start gyro. */
    /* Wake up all sensors. */
    mpu_set_sensors(INV_XYZ_GYRO | INV_XYZ_ACCEL);
    /* Push both gyro and accel data into the FIFO. */
    mpu_configure_fifo(INV_XYZ_GYRO | INV_XYZ_ACCEL);
    mpu_set_sample_rate(DEFAULT_MPU_HZ);
    /* Read back configuration in case it was set improperly. */
    // mpu_get_sample_rate(&gyro_rate);
    // mpu_get_gyro_fsr(&gyro_fsr);
    // mpu_get_accel_fsr(&accel_fsr);

    /* To initialize the DMP:
     * 1. Call dmp_load_motion_driver_firmware(). This pushes the DMP image in
     *    inv_mpu_dmp_motion_driver.h into the MPU memory.
     * 2. Push the gyro and accel orientation matrix to the DMP.
     * 3. Register gesture callbacks. Don't worry, these callbacks won't be
     *    executed unless the corresponding feature is enabled.
     * 4. Call dmp_enable_feature(mask) to enable different features.
     * 5. Call dmp_set_fifo_rate(freq) to select a DMP output rate.
     * 6. Call any feature-specific control functions.
     *
     * To enable the DMP, just call mpu_set_dmp_state(1). This function can
     * be called repeatedly to enable and disable the DMP at runtime.
     *
     * The following is a short summary of the features supported in the DMP
     * image provided in inv_mpu_dmp_motion_driver.c:
     * DMP_FEATURE_LP_QUAT: Generate a gyro-only quaternion on the DMP at
     * 200Hz. Integrating the gyro data at higher rates reduces numerical
     * errors (compared to integration on the MCU at a lower sampling rate).
     * DMP_FEATURE_6X_LP_QUAT: Generate a gyro/accel quaternion on the DMP at
     * 200Hz. Cannot be used in combination with DMP_FEATURE_LP_QUAT.
     * DMP_FEATURE_TAP: Detect taps along the X, Y, and Z axes.
     * DMP_FEATURE_ANDROID_ORIENT: Google's screen rotation algorithm. Triggers
     * an event at the four orientations where the screen should rotate.
     * DMP_FEATURE_GYRO_CAL: Calibrates the gyro data after eight seconds of
     * no motion.
     * DMP_FEATURE_SEND_RAW_ACCEL: Add raw accelerometer data to the FIFO.
     * DMP_FEATURE_SEND_RAW_GYRO: Add raw gyro data to the FIFO.
     * DMP_FEATURE_SEND_CAL_GYRO: Add calibrated gyro data to the FIFO. Cannot
     * be used in combination with DMP_FEATURE_SEND_RAW_GYRO.
     */
    dmp_load_motion_driver_firmware();
    dmp_set_orientation(inv_orientation_matrix_to_scalar(gyro_orientation));
    // dmp_register_tap_cb(tap_cb);
    // dmp_register_android_orient_cb(android_orient_cb);

    /*
     * Known Bug -
     * DMP when enabled will sample sensor data at 200Hz and output to FIFO at the rate
     * specified in the dmp_set_fifo_rate API. The DMP will then sent an interrupt once
     * a sample has been put into the FIFO. Therefore if the dmp_set_fifo_rate is at 25Hz
     * there will be a 25Hz interrupt from the MPU device.
     *
     * There is a known issue in which if you do not enable DMP_FEATURE_TAP
     * then the interrupts will be at 200Hz even if fifo rate
     * is set at a different rate. To avoid this issue include the DMP_FEATURE_TAP
     */
    dmp_enable_feature(DMP_FEATURE_6X_LP_QUAT | DMP_FEATURE_TAP |
        DMP_FEATURE_ANDROID_ORIENT | DMP_FEATURE_SEND_RAW_ACCEL |
        DMP_FEATURE_SEND_CAL_GYRO | DMP_FEATURE_GYRO_CAL);
    dmp_set_fifo_rate(DEFAULT_MPU_HZ);

    long gyro[3], accel[3];

    int result = mpu_run_self_test(gyro, accel);
    if (result == 0x3)
    {
        /* Test passed. We can trust the gyro data here, so let's push it down
         * to the DMP.
         */
        float sens;
        unsigned short accel_sens;
        mpu_get_gyro_sens(&sens);
        gyro[0] = (long)(gyro[0] * sens);
        gyro[1] = (long)(gyro[1] * sens);
        gyro[2] = (long)(gyro[2] * sens);
        dmp_set_gyro_bias(gyro);
        mpu_get_accel_sens(&accel_sens);
        accel[0] *= accel_sens;
        accel[1] *= accel_sens;
        accel[2] *= accel_sens;
        dmp_set_accel_bias(accel);
    }

    mpu_set_dmp_state(1);

    return 0;
}

void MPU6050_Pose(double cal_data[3])
{
   dmp_read_fifo(gyro_raw, accel_raw, quat, &sensor_timestamp, &sensors,&more);
   if (sensors & INV_WXYZ_QUAT )
   {
       q0=quat[0] / q30;
       q1=quat[1] / q30;
       q2=quat[2] / q30;
       q3=quat[3] / q30;

       cal_data[0] = asin(-2 * q1 * q3 + 2 * q0* q2)* 57.3;
       cal_data[1] = atan2(2 * q2 * q3 + 2 * q0 * q1, -2 * q1 * q1 - 2 * q2* q2 + 1)* 57.3;
       cal_data[2] = atan2(2*(q1*q2 + q0*q3),q0*q0+q1*q1-q2*q2-q3*q3) * 57.3;
       // printf("pitch: %.2f    roll:%.2f		yaw:%.2f\r\n",Pitch,Roll,Yaw);
   }
 }
