batmanatucsd/uMouse/Code/mcu_lib.c

#include "mcu_lib.h"


// TODO:
// Don't forget to change the pin numbers

void RCC_Configuration(void)
{
	/* PCLK2 is the APB2 clock */
  /* ADCCLK = PCLK2/6 = 72/6 = 12MHz*/
  // RCC_ADCCLKConfig(RCC_PCLK2_Div6);

  /* ADCCLK = PCLK2/4 for ADC */
  RCC_ADCCLKConfig(RCC_PCLK2_Div4); 

   /* TIM clock enable for PWM */
  RCC_APB1PeriphClockCmd(RCC_APB1Periph_TIM3, ENABLE);

  /* GPIO, ADC clock enable */
  RCC_APB2PeriphClockCmd(RCC_APB2Periph_GPIOA | RCC_APB2Periph_GPIOB |
                         RCC_APB2Periph_GPIOC | RCC_APB2Periph_AFIO |
                         RCC_APB2Periph_ADC1, ENABLE);
}

void GPIO_Configuration(void) 
{
	GPIO_InitTypeDef GPIO_InitStructure;

	// **** GPIO config for digital output push-pull *** //
	GPIO_InitStructure.GPIO_Pin = GPIO_Pin_8 | GPIO_Pin_9;
	GPIO_InitStructure.GPIO_Speed = GPIO_Speed_50MHz;
	GPIO_InitStructure.GPIO_Mode = GPIO_Mode_Out_PP;
	GPIO_Init(GPIOC, &GPIO_InitStructure);

	// **** GPIO config for analog input *** //
	/*
	void GPIO_Configuration(void)
	{
	  GPIO_InitTypeDef GPIO_InitStructure;

	  // Configure PC.02, PC.03 and PC.04 (ADC Channel12, ADC Channel13 and 
	  //   ADC Channel14) as analog inputs 
	  GPIO_InitStructure.GPIO_Pin = GPIO_Pin_2 | GPIO_Pin_3 | GPIO_Pin_4;
	  GPIO_InitStructure.GPIO_Mode = GPIO_Mode_AIN;
	  GPIO_Init(GPIOC, &GPIO_InitStructure);
	}
	*/

	// **** GPIO config for serial connection *** //
	GPIO_InitStructure.GPIO_Pin = GPIO_Pin_10;
	GPIO_InitStructure.GPIO_Mode = GPIO_Mode_IN_FLOATING;
	GPIO_Init(GPIOA, &GPIO_InitStructure);  

	GPIO_InitStructure.GPIO_Pin = GPIO_Pin_9;
	GPIO_InitStructure.GPIO_Speed = GPIO_Speed_50MHz;
	GPIO_InitStructure.GPIO_Mode = GPIO_Mode_AF_PP;
	GPIO_Init(GPIOA, &GPIO_InitStructure);
}

void USART_Configuration(void)
{
	RCC_APB2PeriphClockCmd(RCC_APB2Periph_USART1, ENABLE);
	
	USART_InitTypeDef USART_InitStructure;

	USART_InitStructure.USART_BaudRate = 115200;
	USART_InitStructure.USART_WordLength = USART_WordLength_8b;
	USART_InitStructure.USART_StopBits = USART_StopBits_1;
	USART_InitStructure.USART_Parity = USART_Parity_No;
	USART_InitStructure.USART_HardwareFlowControl = USART_HardwareFlowControl_None;
	USART_InitStructure.USART_Mode = USART_Mode_Rx | USART_Mode_Tx;

	USART_Init(USART1, &USART_InitStructure);
	USART_Cmd(USART1, ENABLE);
}

void ADC_Configuration(void)
{
  ADC_InitTypeDef  ADC_InitStructure;

  /* Put everything back to power-on defaults */
  ADC_DeInit(ADC1);

  /* ADC1 Configuration ------------------------------------------------------*/
  /* ADC1 and ADC2 operate independently */
  ADC_InitStructure.ADC_Mode = ADC_Mode_Independent;
  /* Disable the scan conversion so we do one at a time */
  ADC_InitStructure.ADC_ScanConvMode = DISABLE;
  /* Don't do contimuous conversions - do them on demand */
  ADC_InitStructure.ADC_ContinuousConvMode = DISABLE;
  // Start conversin by software, not an external trigger 
  ADC_InitStructure.ADC_ExternalTrigConv = ADC_ExternalTrigConv_None;
  /* Conversions are 12 bit - put them in the lower 12 bits of the result */
  ADC_InitStructure.ADC_DataAlign = ADC_DataAlign_Right;
  /* Say how many channels would be used by the sequencer */
  ADC_InitStructure.ADC_NbrOfChannel = 1;

  /* Now do the setup */
  ADC_Init(ADC1, &ADC_InitStructure);
  /* Enable ADC1 */
  ADC_Cmd(ADC1, ENABLE);

  /* Enable ADC1 reset calibaration register */
  ADC_ResetCalibration(ADC1);
  /* Check the end of ADC1 reset calibration register */
  while(ADC_GetResetCalibrationStatus(ADC1));
  /* Start ADC1 calibaration */
  ADC_StartCalibration(ADC1);
  /* Check the end of ADC1 calibration */
  while(ADC_GetCalibrationStatus(ADC1));
}

void PWM_Configuration(void)
{
	/* Compute the prescaler value */
  PrescalerValue = (uint16_t) (SystemCoreClock / 24000000) - 1;
  /* Time base configuration */
  TIM_TimeBaseStructure.TIM_Period = 665;
  TIM_TimeBaseStructure.TIM_Prescaler = PrescalerValue;
  TIM_TimeBaseStructure.TIM_ClockDivision = 0;
  TIM_TimeBaseStructure.TIM_CounterMode = TIM_CounterMode_Up;

  TIM_TimeBaseInit(TIM3, &TIM_TimeBaseStructure);

  /* PWM1 Mode configuration: Channel1 */
  TIM_OCInitStructure.TIM_OCMode = TIM_OCMode_PWM1;
  TIM_OCInitStructure.TIM_OutputState = TIM_OutputState_Enable;
  TIM_OCInitStructure.TIM_Pulse = CCR1_Val;
  TIM_OCInitStructure.TIM_OCPolarity = TIM_OCPolarity_High;

  TIM_OC1Init(TIM3, &TIM_OCInitStructure);

  TIM_OC1PreloadConfig(TIM3, TIM_OCPreload_Enable);

  /* PWM1 Mode configuration: Channel2 */
  TIM_OCInitStructure.TIM_OutputState = TIM_OutputState_Enable;
  TIM_OCInitStructure.TIM_Pulse = CCR2_Val;

  TIM_OC2Init(TIM3, &TIM_OCInitStructure);

  TIM_OC2PreloadConfig(TIM3, TIM_OCPreload_Enable);

  /* PWM1 Mode configuration: Channel3 */
  TIM_OCInitStructure.TIM_OutputState = TIM_OutputState_Enable;
  TIM_OCInitStructure.TIM_Pulse = CCR3_Val;

  TIM_OC3Init(TIM3, &TIM_OCInitStructure);

  TIM_OC3PreloadConfig(TIM3, TIM_OCPreload_Enable);

  /* PWM1 Mode configuration: Channel4 */
  TIM_OCInitStructure.TIM_OutputState = TIM_OutputState_Enable;
  TIM_OCInitStructure.TIM_Pulse = CCR4_Val;

  TIM_OC4Init(TIM3, &TIM_OCInitStructure);

  TIM_OC4PreloadConfig(TIM3, TIM_OCPreload_Enable);

  TIM_ARRPreloadConfig(TIM3, ENABLE);

  /* TIM3 enable counter */
  TIM_Cmd(TIM3, ENABLE);
}
