batmanatucsd/uMouse/(commit log)

2014-11-25 gitignore for eagle cad
2014-11-27 add the pin definition
2014-11-27 first design
    [stm32.sch]
2014-12-06 mpu6050 update and small fix
    TODO: change the boot pin
    [stm32.sch]
2014-12-06 TB6612 update & Boot selection removed
    TODO: review the power circuit in the design & connect motor to MCU
    [stm32.sch]
2014-12-06 tb6612 connect to MCU & design improve
    [stm32.sch]
2014-12-06 minor upgrade
    [stm32.sch]
2014-12-08 rearrage files
    [maple-audio-r1-BOM.ods, maple-audio-r1.brd, maple-audio-r1.sch, maple-jtagadapter.sch, maple-r1.brd, maple-r1.sch, maple-r3.brd, maple-r3.sch]
2014-12-08 updated pid.c
2014-12-16 attach the stratup code to the compile
    my fault
2014-12-16 will switch to a modified version linker script for our chip
    copied from
    \Code\STM32F10x_StdPeriph_Lib_V3.5.0\Project\STM32F10x_StdPeriph_Template\TrueSTUDIO\STM3210E-EVAL_XL
2014-12-16 add a option to compile the project for discovery board
2014-12-18 discovery board dataasheet
2014-12-24 update pid and schematic
    [stm32.sch]
2014-12-24 attach the i2c header file
2014-12-25 print maze
2014-12-25 print direction and visited
2014-12-31 avoid printf for less memory use
2014-12-31 circuit remake
    [stm32.sch]
2014-12-31 board making
    [stm32.brd, stm32.sch]
2014-12-31 added framework for wall reading
2015-01-01 board update
    [stm32.brd, stm32.sch]
2015-01-01 started coding for PWM
2015-01-04 need gyro code asap
2015-01-05 add the dma library for i2c and adc & more study needed
2015-01-06 add 5v regulator
    [stm32.brd, stm32.sch]
2015-01-06 refine connection
    [stm32.brd, stm32.sch]
2015-01-07 i2c read test successful (On ADXL345)
2015-01-11 meeting update
    [stm32.brd, stm32.sch]
2015-01-12 Long wall test case successful
2015-01-12 added indicating leds
    [stm32.brd, stm32.sch]
2015-01-14 first test case
2015-01-14 added toggle switch to schematic
    [stm32.brd, stm32.sch]
2015-01-15 meet update 1
    [stm32.brd, stm32.sch]
2015-01-15 meet update 2
    [stm32.brd, stm32.sch]
2015-01-16 meet update 3
    [stm32.brd, stm32.sch]
2015-01-16 meet update 4
    [stm32.brd]
2015-01-16 meet update 5
    [stm32.brd, stm32.sch]
2015-01-16 meet update 6
    [stm32.brd, stm32.sch]
2015-01-17 meet update 7
    [stm32.brd, stm32.sch]
2015-01-17 sleep save
    [stm32.brd, stm32.sch]
2015-01-17 meal save
    [stm32.brd]
2015-01-18 FinalWheel and MotorMount
    [FinalWheel.dwg, MotorMount.dwg]
2015-01-18 first darft
    [stm32.brd, stm32.sch]
2015-01-18 move folder
    [FinalWheel.dwg, MotorMount.dwg, maple-audio-r1-BOM.ods, maple-audio-r1.brd, maple-audio-r1.sch, maple-jtagadapter.sch, maple-r1.brd, maple-r1.sch]
2015-01-19 second draft
    [stm32.brd, stm32.sch]
2015-01-19 changed the transistor to BC847 with package SOT23
    [stm32.brd, stm32.sch]
2015-01-19 update according to the change
    [stm32.brd]
2015-01-19 third draft
    [stm32.brd, stm32.sch]
2015-01-19 minor update
    [stm32.brd]
2015-01-19 crystal update
    [stm32.brd, stm32.sch]
2015-01-22 changed to new phototransistors
    [stm32.brd, stm32.sch]
2015-01-24 updated power to phototransistors and encoders
    [stm32.brd]
2015-01-24 updated power to phototransistors and the encoders
    [stm32.brd, stm32.sch]
2015-01-24 added DRU and CAM files for pcb design
2015-01-24 removed test case
2015-01-24 removed some final wheel files
2015-01-24 removed MotorMount.dwg
    [MotorMount.dwg]
2015-01-24 finished final motormount and wheel
    [MotorMount.dwg, MotorMount.stl, Wheel.dwg, Wheel.stl]
2015-01-24 removed old files from 3D folder
    [FinalWheel.dwg]
2015-01-25 final edition
    [stm32.brd]
2015-01-25 ultimate final edition
    [stm32.brd, stm32.sch]
2015-01-25 gerber 1
    [stm32.drills.xln]
2015-01-29 emergency update
    [stm32.brd, stm32.sch]
2015-01-30 fixing the pcb
    [stm32.brd]
2015-01-30 Revert "fixing the pcb"
    This reverts commit ef2aa02c41244ec6514db540dad705e3626aa598.
    [stm32.brd]
2015-01-30 finish update
    [stm32.brd, stm32.sch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]
2015-01-30 PCB README UPDATE
2015-02-15 Move all i2c function outside of mcu_lib
2015-02-16 fix merge conflict with origin repo
    [DRILEGEND.CFG]
2015-03-13 added dynamic PWM width change
2015-03-26 added mouse files and wrote pwm stuff
2015-03-26 trying to write uart write that sends int
2015-03-26 testing the ir sensors
2015-03-27 finished adc with software trigger
2015-03-30 added musart.h for enabling printf for debugging
2015-03-31 added files for interrupt handlers and wrote codes for injected conversions
2015-04-02 idk its kinda working ir sensors... it was better before...
2015-04-03 everything is stable when all the leds are turned on
2015-04-03 more stable ir sensors
2015-04-05 got the ir sensors working; working on the pid right now
2015-04-05 added pid stuff in the src folder
2015-04-05 added interrupt files
2015-04-05 still working on the pid
2015-04-05 pretty decent pid with two walls
2015-04-05 almost perfect pid, except for the no wall part
2015-04-18 finished 90 deg turns. and trying to merge with the main. pid is little bit messed up
2015-04-18 floodfill.c east wall check fixed
    [floodfill.c]
2015-04-18 ok it infinite loops but correctly sees the walls
    [floodfill.c]
2015-04-19 trying new pid with linearization
2015-04-25 trying to fix stack issues with floodfill... some progress
    [floodfill.c]
2015-04-25 fixing floodfill, sees center wall and doesn't jump in
    [floodfill.c]
2015-05-10 working on pid
2015-05-14 testing i2c 85% finish
2015-05-14 trying to work on the pid
2015-05-14 trying to fix sensor
2015-05-15 3 wall case
2015-05-15 three wall case
2015-05-16 trying to get 3 wall case to work.. not yet, and wont go back to start cell
2015-05-16 pretty good pid and turns
2015-05-16 working I2C commit
2015-05-16 trying to update pid
2015-05-16 updating pid and floodfill
2015-05-16 still trying to put stopping and pid smoothly
2015-05-16 reverting back to floodfill from 2 days ago
    [floodfill.c]
2015-05-17 added motor controls
2015-05-17 labeled motor controls
2015-05-17 working on calibration
2015-05-17 removed print statements from src
2015-05-17 trying to fix the sensor problem
    [mcu_lib.c]
2015-05-17 fixed the ADC problem
2015-05-17 testing hardware i2c
2015-05-17 fixed annoying ass brackets
    [floodfill.c]
2015-08-30 move files around
    [mouse_design.brd, mouse_design.sch]
2015-09-07 new i2c initial
2015-09-08 disable interrupt during usart & refine libs
2015-09-08 better make & bug free delay
    [mcu.c, mcu.h, mcu_delay.c]
2015-09-10 temporarily skip hardware iic
    [inv_mpu.c, inv_mpu_dmp_motion_driver.c, mcu_iic.c, mcu_soft_iic.c, mcu_soft_iic.h, mpu_basic.c]
2015-09-10 adc init
2015-09-13 new adc is ready
    first request the data and do other things and you can get the data back
    later by read it.
2015-09-13 define function in adc
